phoenix-devc/8085--Microproccesor/README.md

# 8085-Microprocessor
Semester 6 Microprocessor Project
Youtube Video Link: https://youtu.be/vXMi8Nels3E
