phoenix-devc/8085--Microproccesor/Proposal Gantt Chart.docx

Task | Start Date(DD/MM/YY) | End Date(DD/MM/YY) | Duration
Project Proposal
Basics of 8085 & Assembly Language
Analysing Hardware Requirements
Schematic Development
Constructing the Board Layout
SD(1): Basic Tic-Tac-Toe Model
SD(2): Constructing Minmax Algorithm Model
Ordering and Obtaining the PCB
Fabricating the Board
Conducting Alpha Tests
