phoenix-devc/8085--Microproccesor/Model_1 (9).pdf

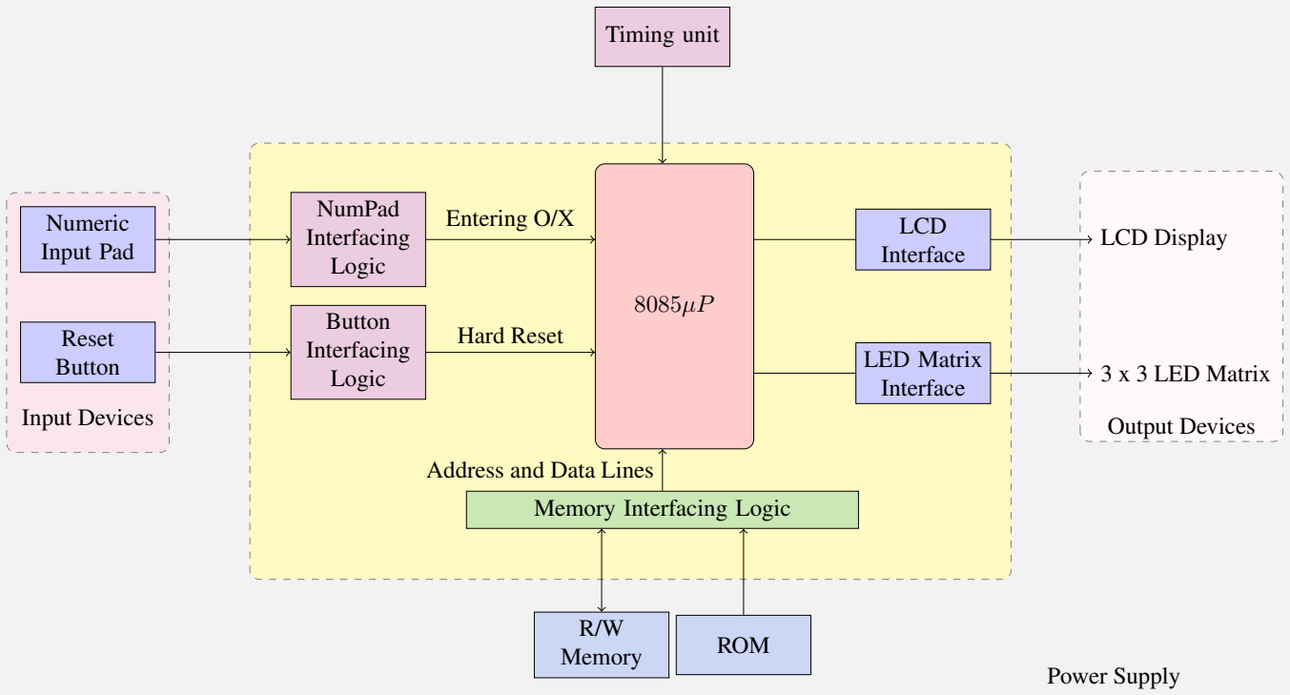
[picture p14: figure]
Numeric Input Pad; Power Supply; Reset Button; NumPad Interfacing Logic; Button Interfacing Logic; Memory Interfacing Logic; Memory; ROM; Timing unit; Entering O/X; Hard Reset; Address and Data Lines; Input Devices; Output Devices; LCD Interface; LCD Display; LED Matrix; Interface; 3 x 3 LED Matrix
