phoenix-devc/8085--Microproccesor/FINALGANTTCHARTSMART.png

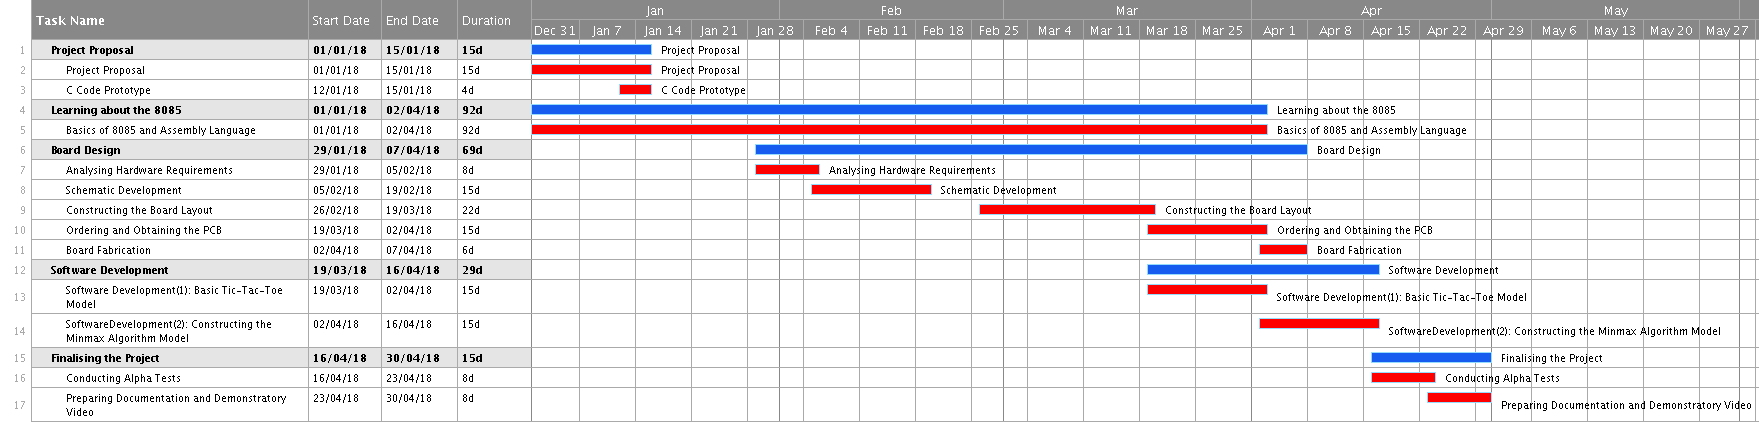
FINALGANTTCHARTSMART.png
