phoenix-devc/8085--Microproccesor/ganttusingsmartsheet.png

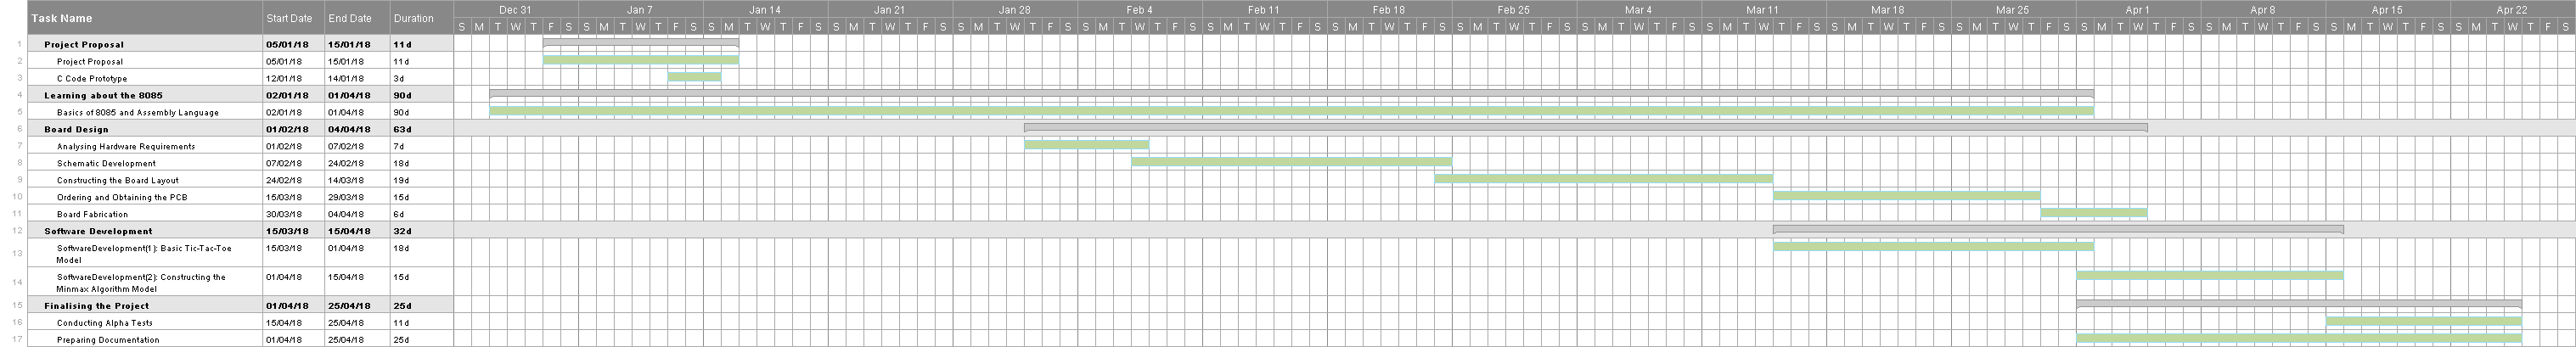
ganttusingsmartsheet.png
