phoenix-devc/8085--Microproccesor/Schematic/main_schematic_2.sch

## EAGLE design Schematic/main_schematic_2.sch (2018-03-11)

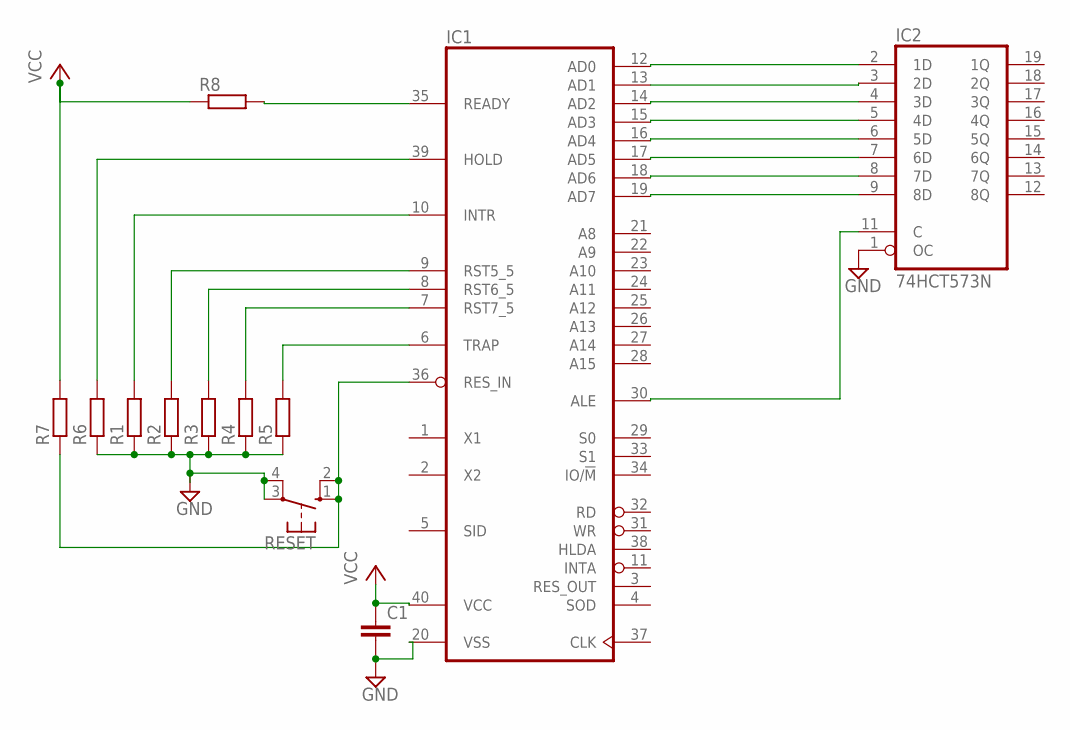
[picture p17: schematic main_schematic_2.sch]

Parts:
C1: C2,5-3; C2.5-3
IC1: 8085; DIL40
IC2: 74HCT573N; DIL20
R1, R2, R3, R4, R5, R6, R7, R8: R0204/7; 0204/7
RESET: 10-XX; B3F-10XX

Connections:
GND: C1.2, IC1.20 (VSS), R1.1, R2.1, R3.1, R4.1, R5.1, R6.1, RESET.3, RESET.4 (P1)
unnamed: IC1.39 (HOLD), R6.2
unnamed: IC1.10 (INTR), R1.2
unnamed: IC1.9 (RST5_5), R2.2
unnamed: IC1.8 (RST6_5), R3.2
unnamed: IC1.7 (RST7_5), R4.2
unnamed: IC1.6 (TRAP), R5.2
unnamed: IC1.36 (RES_IN), R7.1, RESET.1 (S), RESET.2 (S1)
unnamed: IC1.35 (READY), R8.2
unnamed: IC1.30 (ALE), IC2.11 (C)
unnamed: IC1.12 (AD0), IC2.2 (1D)
unnamed: IC1.13 (AD1), IC2.3 (2D)
unnamed: IC1.14 (AD2), IC2.4 (3D)
unnamed: IC1.15 (AD3), IC2.5 (4D)
unnamed: IC1.16 (AD4), IC2.6 (5D)
unnamed: IC1.17 (AD5), IC2.7 (6D)
unnamed: IC1.18 (AD6), IC2.8 (7D)
unnamed: IC1.19 (AD7), IC2.9 (8D)
VCC: C1.1, IC1.40 (VCC), R7.2, R8.1
