phoenix-devc/8085--Microproccesor/Schematic/main_schematic_3.sch

## EAGLE design Schematic/main_schematic_3.sch (2018-03-14)

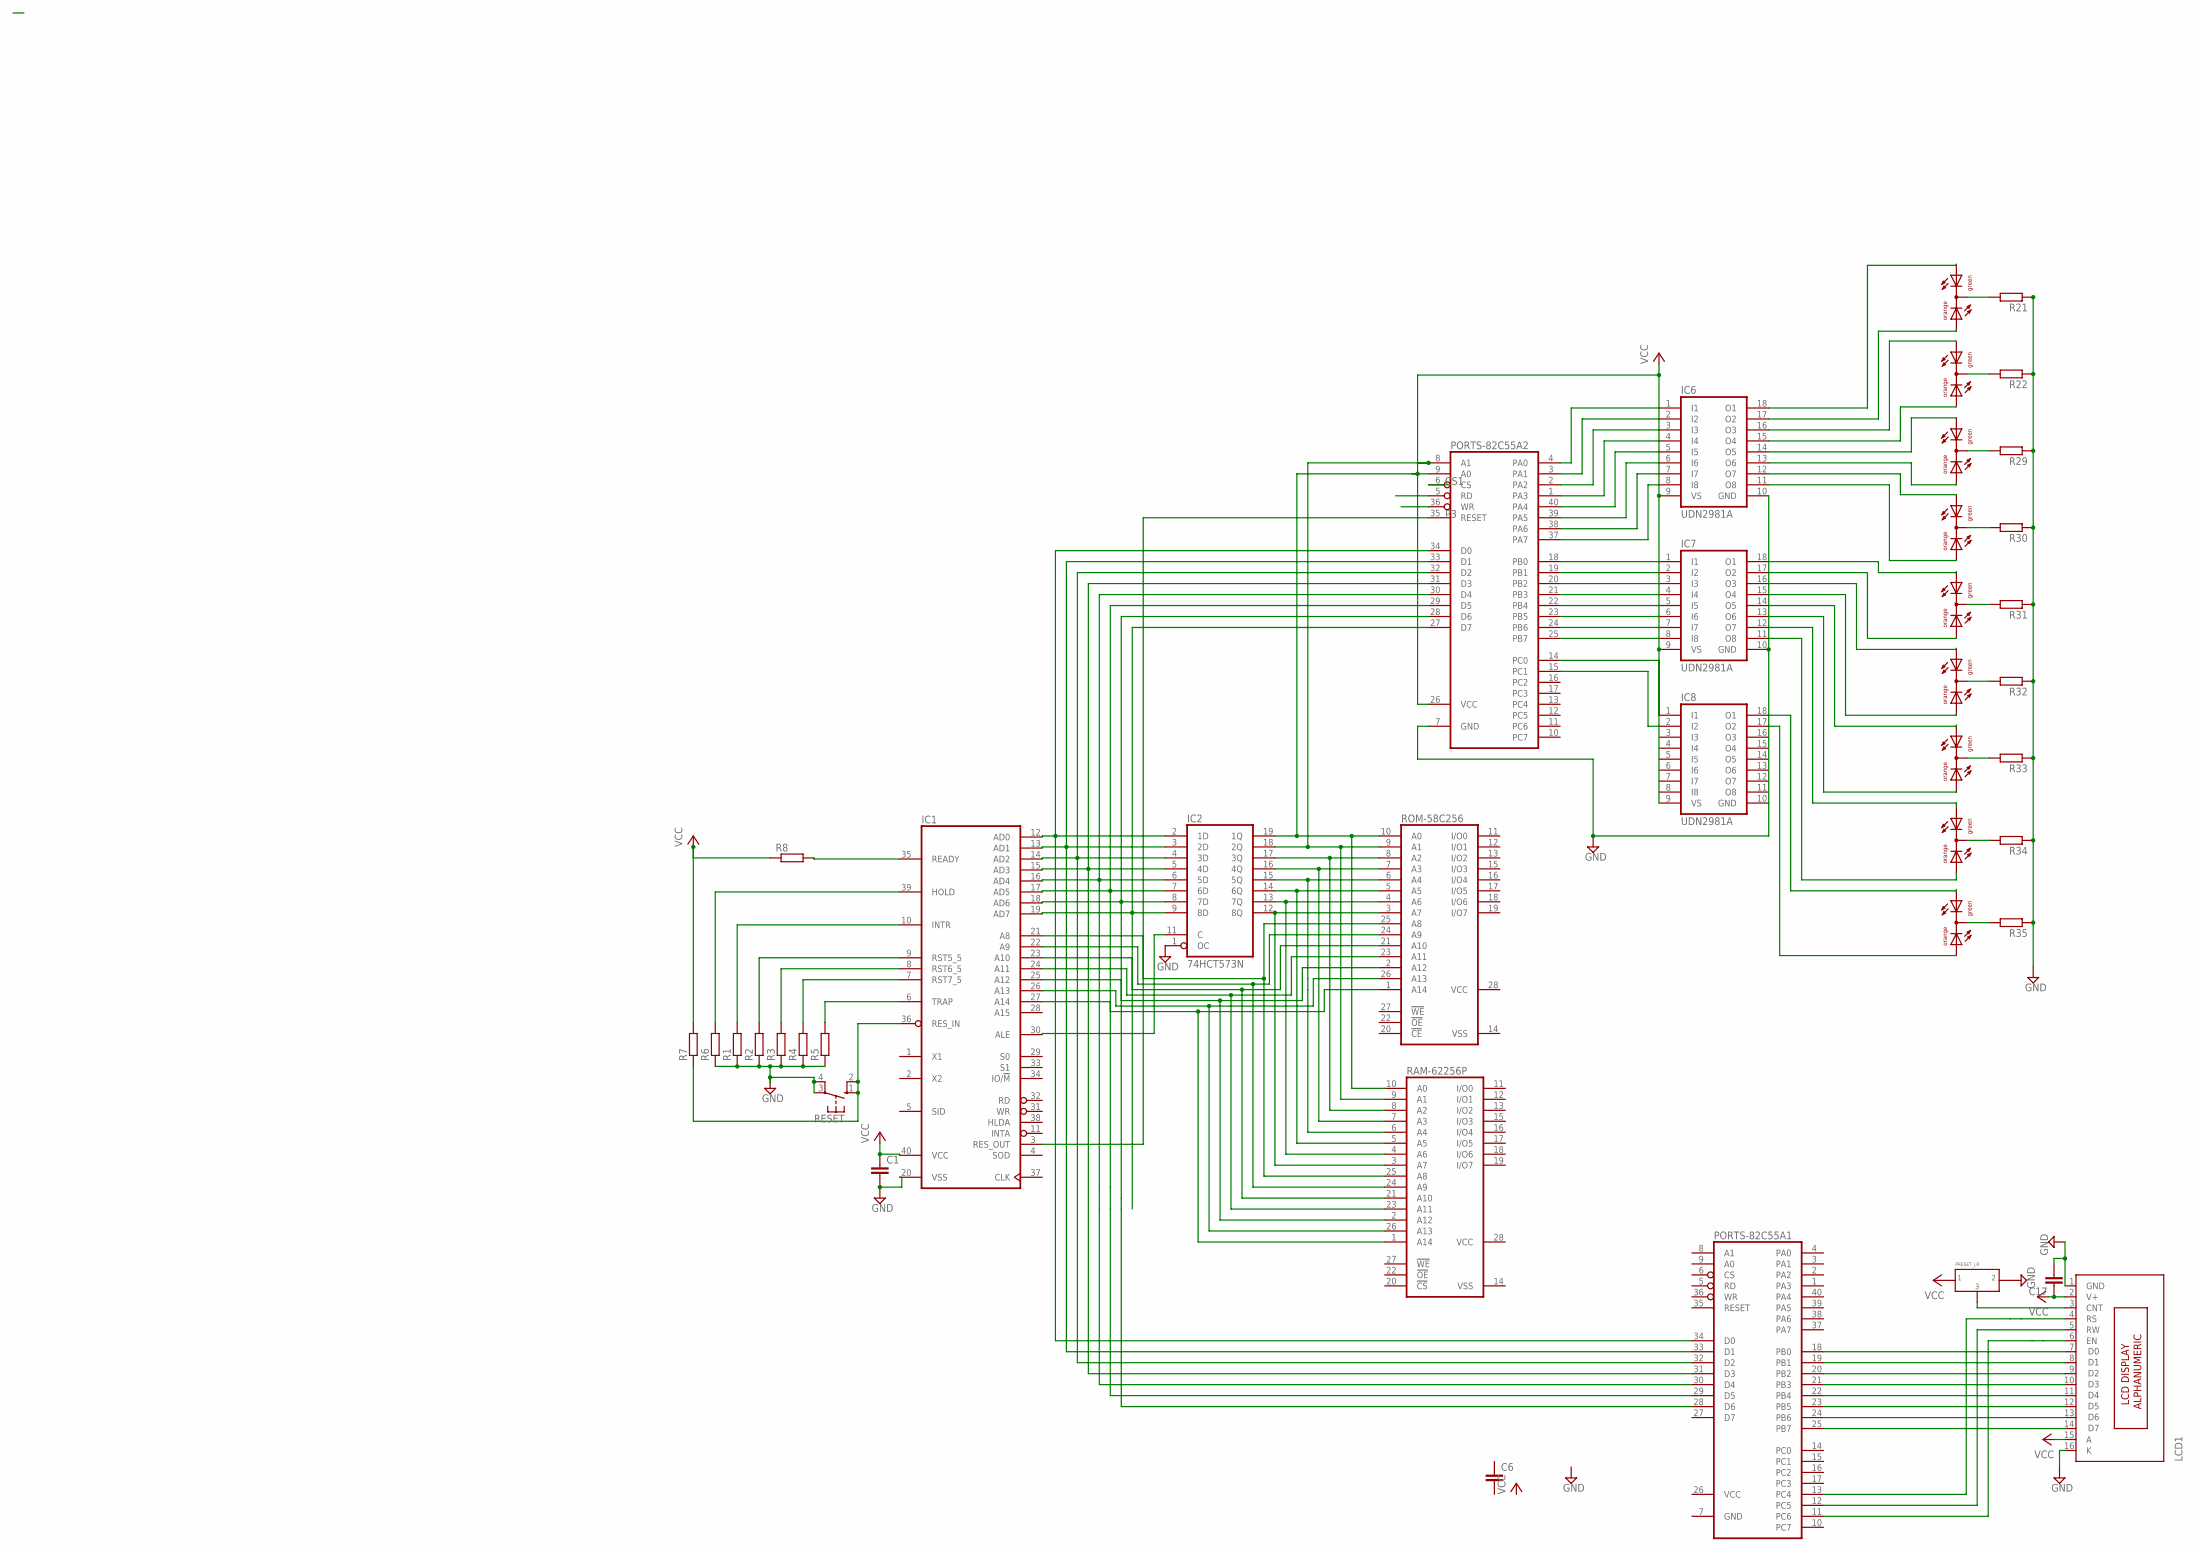
[picture p18: schematic main_schematic_3.sch]

Parts:
C1: C2,5-3; C2.5-3
C6: C-EU050-024X044; C050-024X044
C17: C-EU025-024X044; C025-024X044
IC1: 8085; DIL40
IC2: 74HCT573N; DIL20
IC6, IC7, IC8: UDN2981A; DIL18
LCD1: 16X2LCD; 16X2_LCD
LED1, LED11, LED12, LED13, LED14, LED15, LED16, LED17, LED18: TLUV5300
PORTS-82C55A1, PORTS-82C55A2: 82C55A; DIL40
R1, R2, R3, R4, R5, R6, R7, R8: R0204/7; 0204/7
R21, R22, R29, R30, R31, R32, R33, R34, R35: R-EU_0204/7; 0204/7
RAM-62256P: 62256P; DIL28-6
RESET: 10-XX; B3F-10XX
ROM-58C256: 58C256P; DIL28-6
U$2: PRESET_LR

Connections:
A0: PORTS-82C55A2.9 (A0)
A1: IC2.18 (2Q), PORTS-82C55A2.8 (A1), RAM-62256P.9 (A1), ROM-58C256.9 (A1)
CS1: PORTS-82C55A2.6 (CS)
GND: C1.2, C17.2, IC1.20 (VSS), IC6.10 (GND), IC7.10 (GND), IC8.10 (GND), LCD1.1 (GND), LCD1.16 (K), PORTS-82C55A2.7 (GND), R1.1, R2.1, R3.1, R4.1, R5.1, R6.1, R21.1, R22.1, R29.1, R30.1, R31.1, R32.1, R33.1, R34.1, R35.1, RESET.3, RESET.4 (P1), U$2.P$2 (2)
unnamed: IC1.39 (HOLD), R6.2
unnamed: IC1.10 (INTR), R1.2
unnamed: IC1.9 (RST5_5), R2.2
unnamed: IC1.8 (RST6_5), R3.2
unnamed: IC1.7 (RST7_5), R4.2
unnamed: IC1.6 (TRAP), R5.2
unnamed: IC1.36 (RES_IN), R7.1, RESET.1 (S), RESET.2 (S1)
unnamed: IC1.35 (READY), R8.2
unnamed: IC1.30 (ALE), IC2.11 (C)
unnamed: IC6.1 (I1), PORTS-82C55A2.4 (PA0)
unnamed: IC6.2 (I2), PORTS-82C55A2.3 (PA1)
unnamed: IC7.1 (I1), PORTS-82C55A2.18 (PB0)
unnamed: IC6.3 (I3), PORTS-82C55A2.2 (PA2)
unnamed: IC6.4 (I4), PORTS-82C55A2.1 (PA3)
unnamed: IC6.5 (I5), PORTS-82C55A2.40 (PA4)
unnamed: IC6.6 (I6), PORTS-82C55A2.39 (PA5)
unnamed: IC6.7 (I7), PORTS-82C55A2.38 (PA6)
unnamed: LCD1.4 (RS), PORTS-82C55A1.13 (PC4)
unnamed: LCD1.5 (RW), PORTS-82C55A1.12 (PC5)
unnamed: LCD1.6 (EN), PORTS-82C55A1.11 (PC6)
unnamed: LCD1.14 (D7), PORTS-82C55A1.25 (PB7)
unnamed: LCD1.13 (D6), PORTS-82C55A1.24 (PB6)
unnamed: LCD1.12 (D5), PORTS-82C55A1.23 (PB5)
unnamed: IC2.17 (3Q), RAM-62256P.8 (A2), ROM-58C256.8 (A2)
unnamed: IC2.16 (4Q), RAM-62256P.7 (A3), ROM-58C256.7 (A3)
unnamed: LCD1.11 (D4), PORTS-82C55A1.22 (PB4)
unnamed: LCD1.10 (D3), PORTS-82C55A1.21 (PB3)
unnamed: LCD1.9 (D2), PORTS-82C55A1.20 (PB2)
unnamed: LCD1.8 (D1), PORTS-82C55A1.19 (PB1)
unnamed: LCD1.7 (D0), PORTS-82C55A1.18 (PB0)
unnamed: LCD1.3 (CNT), U$2.P$3 (3)
unnamed: IC2.15 (5Q), RAM-62256P.6 (A4), ROM-58C256.6 (A4)
unnamed: IC2.14 (6Q), RAM-62256P.5 (A5), ROM-58C256.5 (A5)
unnamed: IC2.13 (7Q), RAM-62256P.4 (A6), ROM-58C256.4 (A6)
unnamed: IC2.12 (8Q), RAM-62256P.3 (A7), ROM-58C256.3 (A7)
unnamed: IC1.21 (A8), RAM-62256P.25 (A8), ROM-58C256.25 (A8)
unnamed: IC1.22 (A9), RAM-62256P.24 (A9), ROM-58C256.24 (A9)
unnamed: IC1.23 (A10), RAM-62256P.21 (A10), ROM-58C256.21 (A10)
unnamed: IC1.24 (A11), RAM-62256P.23 (A11), ROM-58C256.23 (A11)
unnamed: IC1.25 (A12), RAM-62256P.2 (A12), ROM-58C256.2 (A12)
unnamed: IC1.26 (A13), RAM-62256P.26 (A13), ROM-58C256.26 (A13)
unnamed: IC1.27 (A14), RAM-62256P.1 (A14), ROM-58C256.1 (A14)
unnamed: IC6.8 (I8), PORTS-82C55A2.37 (PA7)
unnamed: IC7.2 (I2), PORTS-82C55A2.19 (PB1)
unnamed: IC7.3 (I3), PORTS-82C55A2.20 (PB2)
unnamed: IC7.4 (I4), PORTS-82C55A2.21 (PB3)
unnamed: IC7.5 (I5), PORTS-82C55A2.22 (PB4)
unnamed: IC7.6 (I6), PORTS-82C55A2.23 (PB5)
unnamed: IC7.7 (I7), PORTS-82C55A2.24 (PB6)
unnamed: IC7.8 (I8), PORTS-82C55A2.25 (PB7)
unnamed: IC8.1 (I1), PORTS-82C55A2.14 (PC0)
unnamed: IC8.2 (I2), PORTS-82C55A2.15 (PC1)
unnamed: IC6.18 (O1), LED1.AG
unnamed: IC6.17 (O2), LED1.AO
unnamed: IC6.16 (O3), LED11.AG
unnamed: IC6.15 (O4), LED11.AO
unnamed: IC6.14 (O5), LED12.AG
unnamed: IC6.13 (O6), LED12.AO
unnamed: IC6.12 (O7), LED13.AG
unnamed: IC6.11 (O8), LED13.AO
unnamed: IC7.18 (O1), LED14.AG
unnamed: IC7.17 (O2), LED14.AO
unnamed: IC7.16 (O3), LED15.AG
unnamed: IC7.15 (O4), LED15.AO
unnamed: IC7.14 (O5), LED16.AG
unnamed: IC7.13 (O6), LED16.AO
unnamed: IC7.12 (O7), LED17.AG
unnamed: IC7.11 (O8), LED17.AO
unnamed: IC8.18 (O1), LED18.AG
unnamed: IC8.17 (O2), LED18.AO
unnamed: LED18.CC, R35.2
unnamed: LED17.CC, R34.2
unnamed: LED16.CC, R33.2
unnamed: LED15.CC, R32.2
unnamed: LED13.CC, R30.2
unnamed: LED12.CC, R29.2
unnamed: LED11.CC, R22.2
unnamed: LED1.CC, R21.2
unnamed: LED14.CC, R31.2
NETSEG1: PORTS-82C55A2.5 (RD)
P1: IC1.12 (AD0), IC2.2 (1D), PORTS-82C55A1.34 (D0), PORTS-82C55A2.34 (D0)
P2: IC1.13 (AD1), IC2.3 (2D), PORTS-82C55A1.33 (D1), PORTS-82C55A2.33 (D1)
P3: IC1.3 (RES_OUT), PORTS-82C55A2.35 (RESET)
P4: IC1.14 (AD2), IC2.4 (3D), PORTS-82C55A1.32 (D2), PORTS-82C55A2.32 (D2)
P5: IC1.15 (AD3), IC2.5 (4D), PORTS-82C55A1.31 (D3), PORTS-82C55A2.31 (D3)
P6: IC1.17 (AD5), IC2.7 (6D), PORTS-82C55A1.29 (D5), PORTS-82C55A2.29 (D5)
P7: IC1.19 (AD7), IC2.9 (8D), PORTS-82C55A2.27 (D7)
P8: IC1.18 (AD6), IC2.8 (7D), PORTS-82C55A1.28 (D6), PORTS-82C55A2.28 (D6)
P9: IC1.16 (AD4), IC2.6 (5D), PORTS-82C55A1.30 (D4), PORTS-82C55A2.30 (D4)
VCC: C1.1, C17.1, IC1.40 (VCC), IC2.19 (1Q), IC6.9 (VS), IC7.9 (VS), IC8.9 (VS), LCD1.2 (V+), LCD1.15 (A), PORTS-82C55A2.26 (VCC), R7.2, R8.1, RAM-62256P.10 (A0), ROM-58C256.10 (A0), U$2.P$1 (1)
