phoenix-devc/8085--Microproccesor/Schematic/main_schematic_8.sch

## EAGLE design Schematic/main_schematic_8.sch (2018-03-17)

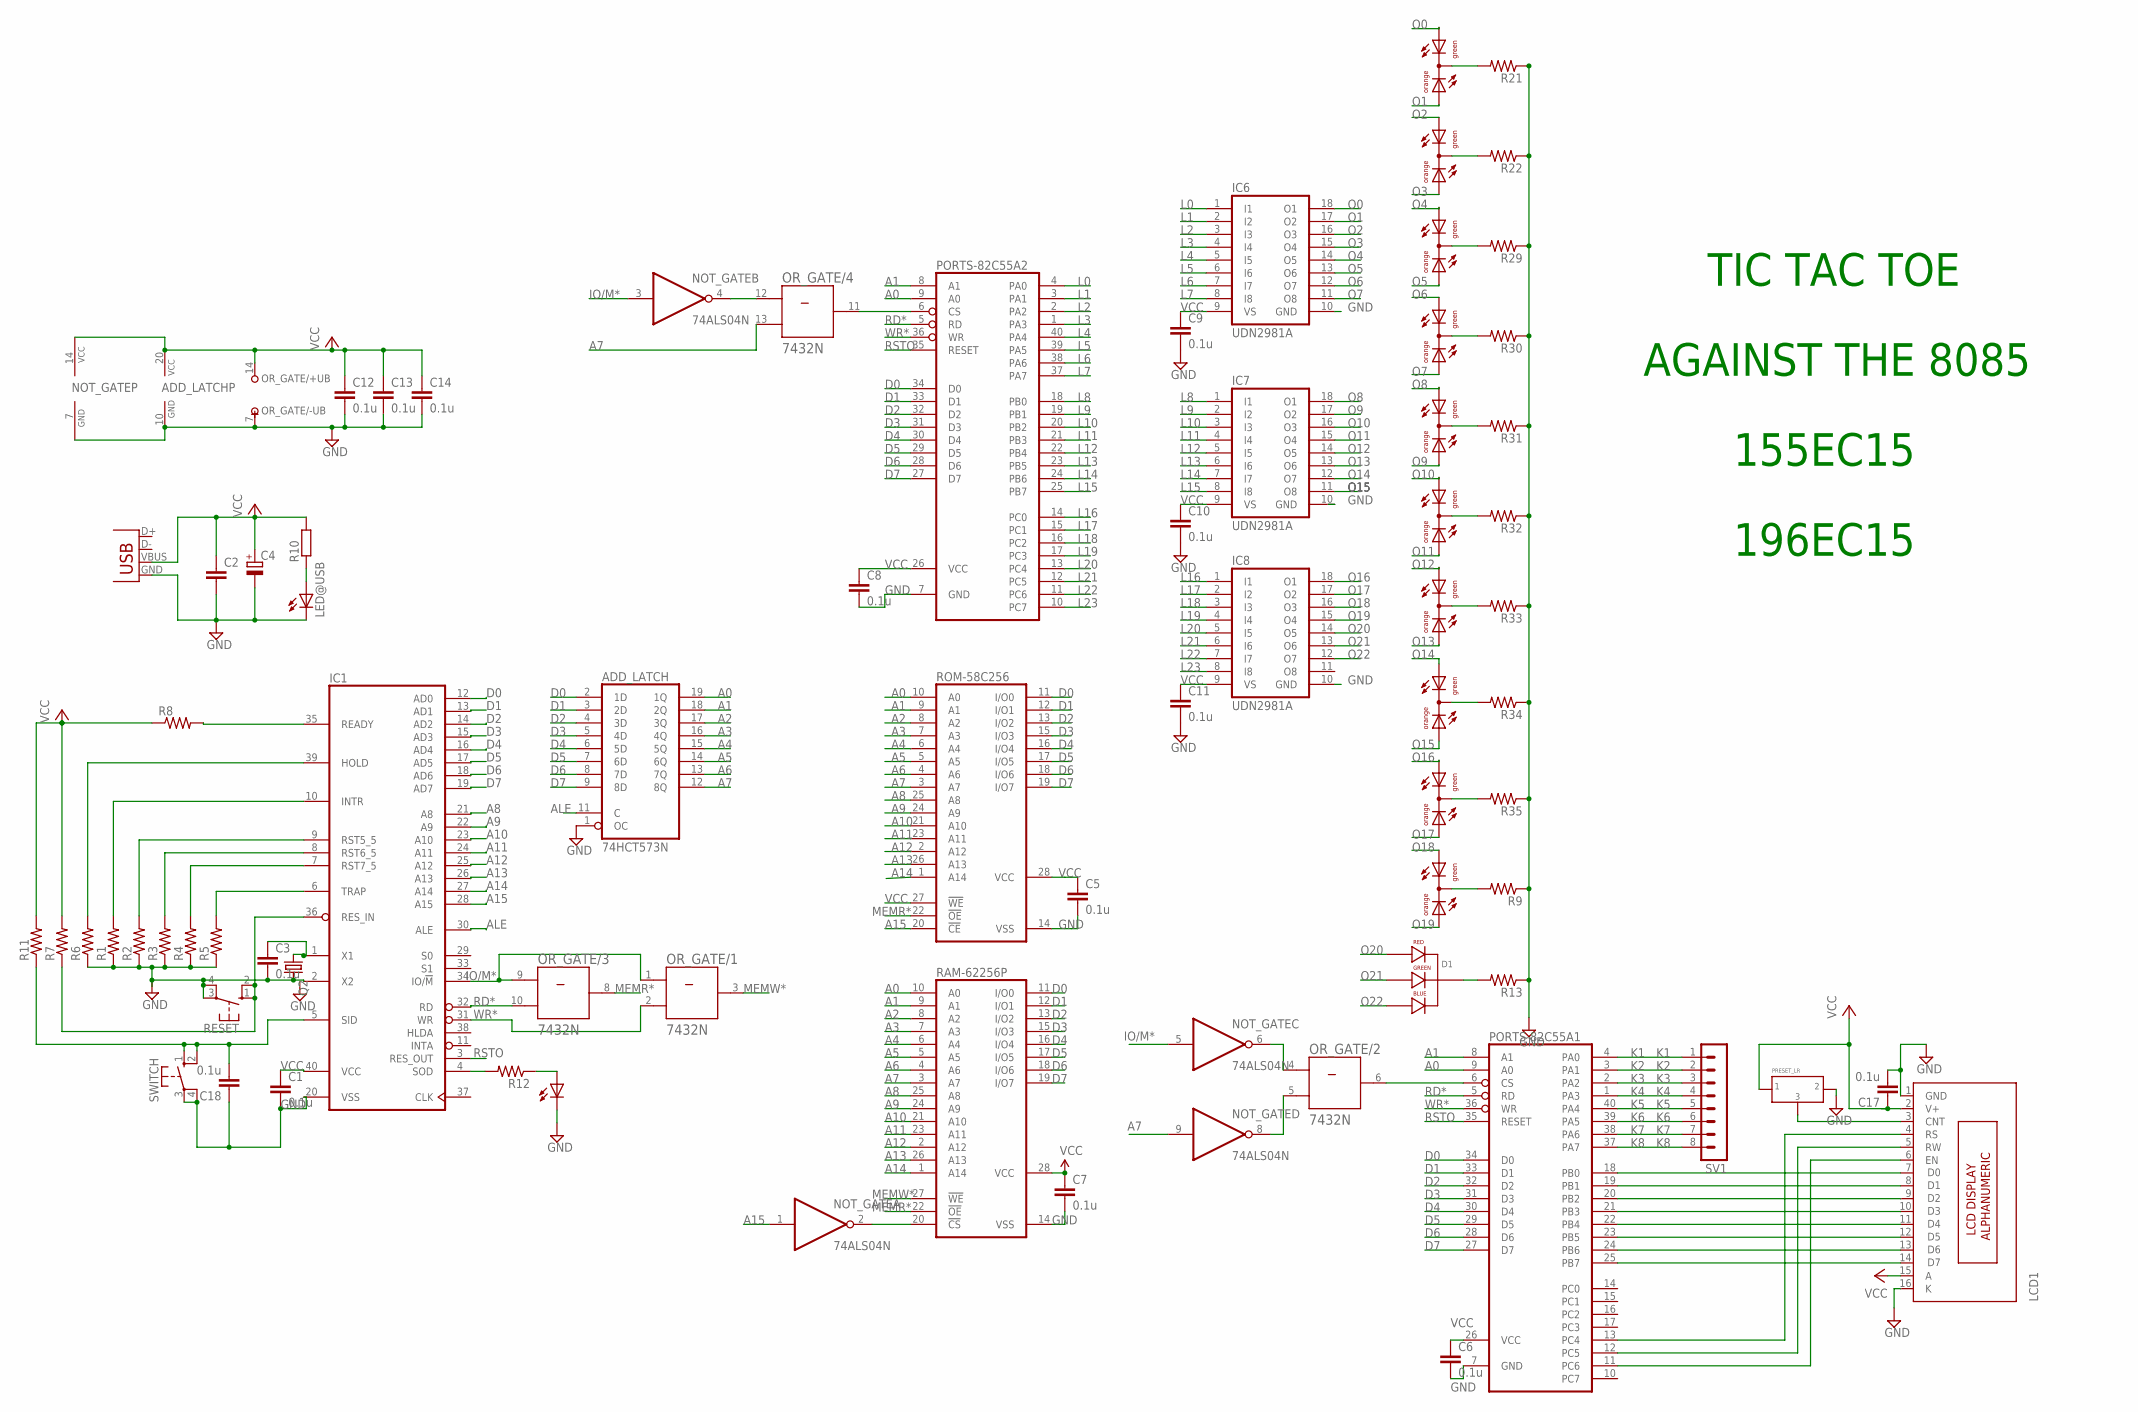
[picture p21: schematic main_schematic_8.sch]

Parts:
ADD_LATCH: 74HCT573N; DIL20
C1, C18: 0.1u; C2.5-3
C2: C-EU025-024X044; C025-024X044
C3, C5, C7, C8, C9, C10, C11, C12, C13, C14, C17: 0.1u; C025-024X044
C4: CPOL-EUE5-8.5; E5-8,5
C6: 0.1u; C050-024X044
D1: LED-RGB-CC-THRUCLEAR; LED-RGB-THRU
IC1: 8085; DIL40
IC6, IC7, IC8: UDN2981A; DIL18
LCD1: 16X2LCD; 16X2_LCD
LED@SOD: LED3MM
LED@USB: LED5MM
LEDA: TLUV5300
LEDB: TLUV5300
LEDC: TLUV5300
LEDD: TLUV5300
LEDE: TLUV5300
LEDF: TLUV5300
LEDG: TLUV5300
LEDH: TLUV5300
LEDI: TLUV5300
LEDJ: TLUV5300
NOT_GATE: 74ALS04N; DIL14
OR_GATE: 7432N; DIL14
PORTS-82C55A1, PORTS-82C55A2: 82C55A; DIL40
Q2: CRYSTALHC49US; HC49US
R1, R2, R3, R4, R5, R6, R7, R8, R9, R11, R12, R13, R21, R22, R29, R30, R31, R32, R33, R34, R35: R-US_0204/2V; 0204V
R10: R-EU_0204/7; 0204/7
RAM-62256P: 62256P; DIL28-6
RESET: 10-XX; B3F-10XX
ROM-58C256: 58C256P; DIL28-6
SV1: MA08-1
SWITCH: 10-XX; B3F-10XX
U$2: PRESET_LR
X1: USBSMD; USB-MINIB

Connections:
A0: ADD_LATCH.19 (1Q), PORTS-82C55A1.9 (A0), PORTS-82C55A2.9 (A0), RAM-62256P.10 (A0), ROM-58C256.10 (A0)
A1: ADD_LATCH.18 (2Q), PORTS-82C55A1.8 (A1), PORTS-82C55A2.8 (A1), RAM-62256P.9 (A1), ROM-58C256.9 (A1)
A2: ADD_LATCH.17 (3Q), RAM-62256P.8 (A2), ROM-58C256.8 (A2)
A3: ADD_LATCH.16 (4Q), RAM-62256P.7 (A3), ROM-58C256.7 (A3)
A4: ADD_LATCH.15 (5Q), RAM-62256P.6 (A4), ROM-58C256.6 (A4)
A5: ADD_LATCH.14 (6Q), RAM-62256P.5 (A5), ROM-58C256.5 (A5)
A6: ADD_LATCH.13 (7Q), RAM-62256P.4 (A6), ROM-58C256.4 (A6)
A7: ADD_LATCH.12 (8Q), NOT_GATE.9 (I), OR_GATE.13 (B), RAM-62256P.3 (A7), ROM-58C256.3 (A7)
A8: IC1.21 (A8), RAM-62256P.25 (A8), ROM-58C256.25 (A8)
A9: IC1.22 (A9), RAM-62256P.24 (A9), ROM-58C256.24 (A9)
A10: IC1.23 (A10), RAM-62256P.21 (A10), ROM-58C256.21 (A10)
A11: IC1.24 (A11), RAM-62256P.23 (A11), ROM-58C256.23 (A11)
A12: IC1.25 (A12), RAM-62256P.2 (A12), ROM-58C256.2 (A12)
A13: IC1.26 (A13), RAM-62256P.26 (A13), ROM-58C256.26 (A13)
A14: IC1.27 (A14), RAM-62256P.1 (A14), ROM-58C256.1 (A14)
A15: IC1.28 (A15), NOT_GATE.1 (I), ROM-58C256.20 (!CE)
ALE: ADD_LATCH.11 (C), IC1.30 (ALE)
D0: ADD_LATCH.2 (1D), IC1.12 (AD0), PORTS-82C55A1.34 (D0), PORTS-82C55A2.34 (D0), RAM-62256P.11 (I/O0), ROM-58C256.11 (I/O0)
D1: ADD_LATCH.3 (2D), IC1.13 (AD1), PORTS-82C55A1.33 (D1), PORTS-82C55A2.33 (D1), RAM-62256P.12 (I/O1), ROM-58C256.12 (I/O1)
D2: ADD_LATCH.4 (3D), IC1.14 (AD2), PORTS-82C55A1.32 (D2), PORTS-82C55A2.32 (D2), RAM-62256P.13 (I/O2), ROM-58C256.13 (I/O2)
D3: ADD_LATCH.5 (4D), IC1.15 (AD3), PORTS-82C55A1.31 (D3), PORTS-82C55A2.31 (D3), RAM-62256P.15 (I/O3), ROM-58C256.15 (I/O3)
D4: ADD_LATCH.6 (5D), IC1.16 (AD4), PORTS-82C55A1.30 (D4), PORTS-82C55A2.30 (D4), RAM-62256P.16 (I/O4), ROM-58C256.16 (I/O4)
D5: ADD_LATCH.7 (6D), IC1.17 (AD5), PORTS-82C55A1.29 (D5), PORTS-82C55A2.29 (D5), RAM-62256P.17 (I/O5), ROM-58C256.17 (I/O5)
D6: ADD_LATCH.8 (7D), IC1.18 (AD6), PORTS-82C55A1.28 (D6), PORTS-82C55A2.28 (D6), RAM-62256P.18 (I/O6), ROM-58C256.18 (I/O6)
D7: ADD_LATCH.9 (8D), IC1.19 (AD7), PORTS-82C55A1.27 (D7), PORTS-82C55A2.27 (D7), RAM-62256P.19 (I/O7), ROM-58C256.19 (I/O7)
GND: ADD_LATCH.1 (OC), ADD_LATCH.10 (GND), C1.2, C2.2, C3.2, C4.-, C5.2, C6.2, C7.2, C8.2, C9.2, C10.2, C11.2, C12.2, C13.2, C14.2, C17.2, C18.1, IC1.2 (X2), IC1.20 (VSS), IC6.10 (GND), IC7.10 (GND), IC8.10 (GND), LCD1.1 (GND), LCD1.16 (K), LED@SOD.K (C), LED@USB.K (C), NOT_GATE.7 (GND), OR_GATE.7 (-UB), PORTS-82C55A1.7 (GND), PORTS-82C55A2.7 (GND), Q2.2, R1.1, R2.1, R3.1, R4.1, R5.1, R6.1, R9.1, R13.1, R21.1, R22.1, R29.1, R30.1, R31.1, R32.1, R33.1, R34.1, R35.1, RAM-62256P.14 (VSS), RESET.3, RESET.4 (P1), ROM-58C256.14 (VSS), SWITCH.3, SWITCH.4 (P1), U$2.P$2 (2), X1.GND
IO/M*: IC1.34 (IO/!M), NOT_GATE.3 (I), NOT_GATE.5 (I), OR_GATE.1 (A), OR_GATE.9 (A)
K1: PORTS-82C55A1.4 (PA0), SV1.1
K2: PORTS-82C55A1.3 (PA1), SV1.2
K3: PORTS-82C55A1.2 (PA2), SV1.3
K4: PORTS-82C55A1.1 (PA3), SV1.4
K5: PORTS-82C55A1.40 (PA4), SV1.5
K6: PORTS-82C55A1.39 (PA5), SV1.6
K7: PORTS-82C55A1.38 (PA6), SV1.7
K8: PORTS-82C55A1.37 (PA7), SV1.8
L0: IC6.1 (I1), PORTS-82C55A2.4 (PA0)
L1: IC6.2 (I2), PORTS-82C55A2.3 (PA1)
L2: IC6.3 (I3), PORTS-82C55A2.2 (PA2)
L3: IC6.4 (I4), PORTS-82C55A2.1 (PA3)
L4: IC6.5 (I5), PORTS-82C55A2.40 (PA4)
L5: IC6.6 (I6), PORTS-82C55A2.39 (PA5)
L6: IC6.7 (I7), PORTS-82C55A2.38 (PA6)
L7: IC6.8 (I8), PORTS-82C55A2.37 (PA7)
L8: IC7.1 (I1), PORTS-82C55A2.18 (PB0)
L9: IC7.2 (I2), PORTS-82C55A2.19 (PB1)
L10: IC7.3 (I3), PORTS-82C55A2.20 (PB2)
L11: IC7.4 (I4), PORTS-82C55A2.21 (PB3)
L12: IC7.5 (I5), PORTS-82C55A2.22 (PB4)
L13: IC7.6 (I6), PORTS-82C55A2.23 (PB5)
L14: IC7.7 (I7), PORTS-82C55A2.24 (PB6)
L15: IC7.8 (I8), PORTS-82C55A2.25 (PB7)
L16: IC8.1 (I1), PORTS-82C55A2.14 (PC0)
L17: IC8.2 (I2), PORTS-82C55A2.15 (PC1)
L18: IC8.3 (I3), PORTS-82C55A2.16 (PC2)
L19: IC8.4 (I4), PORTS-82C55A2.17 (PC3)
L20: IC8.5 (I5), PORTS-82C55A2.13 (PC4)
L21: IC8.6 (I6), PORTS-82C55A2.12 (PC5)
L22: IC8.7 (I7), PORTS-82C55A2.11 (PC6)
L23: IC8.8 (I8), PORTS-82C55A2.10 (PC7)
MEMR*: OR_GATE.8 (Y), RAM-62256P.22 (!OE), ROM-58C256.22 (!OE)
MEMW*: OR_GATE.3 (Y), RAM-62256P.27 (!WE)
unnamed: IC1.39 (HOLD), R6.2
unnamed: IC1.10 (INTR), R1.2
unnamed: IC1.9 (RST5_5), R2.2
unnamed: IC1.8 (RST6_5), R3.2
unnamed: IC1.7 (RST7_5), R4.2
unnamed: IC1.6 (TRAP), R5.2
unnamed: IC1.36 (RES_IN), R7.1, RESET.1 (S), RESET.2 (S1)
unnamed: IC1.35 (READY), R8.2
unnamed: C18.2, IC1.5 (SID), R11.1, SWITCH.1 (S), SWITCH.2 (S1)
unnamed: C3.1, IC1.1 (X1), Q2.1
unnamed: NOT_GATE.2 (O), RAM-62256P.20 (!CS)
unnamed: D1.2 (CATHODE), R13.2
unnamed: NOT_GATE.6 (O), OR_GATE.4 (A)
unnamed: IC1.4 (SOD), R12.2
unnamed: LED@SOD.A, R12.1
unnamed: OR_GATE.6 (Y), PORTS-82C55A1.6 (CS)
unnamed: OR_GATE.11 (Y), PORTS-82C55A2.6 (CS)
unnamed: LCD1.4 (RS), PORTS-82C55A1.13 (PC4)
unnamed: LCD1.5 (RW), PORTS-82C55A1.12 (PC5)
unnamed: LCD1.6 (EN), PORTS-82C55A1.11 (PC6)
unnamed: LEDJ.CC, R9.2
unnamed: NOT_GATE.4 (O), OR_GATE.12 (A)
unnamed: NOT_GATE.8 (O), OR_GATE.5 (B)
unnamed: LED@USB.A, R10.1
unnamed: LCD1.14 (D7), PORTS-82C55A1.25 (PB7)
unnamed: LCD1.13 (D6), PORTS-82C55A1.24 (PB6)
unnamed: LCD1.12 (D5), PORTS-82C55A1.23 (PB5)
unnamed: LCD1.11 (D4), PORTS-82C55A1.22 (PB4)
unnamed: LCD1.10 (D3), PORTS-82C55A1.21 (PB3)
unnamed: LCD1.9 (D2), PORTS-82C55A1.20 (PB2)
unnamed: LCD1.8 (D1), PORTS-82C55A1.19 (PB1)
unnamed: LCD1.7 (D0), PORTS-82C55A1.18 (PB0)
unnamed: LCD1.3 (CNT), U$2.P$3 (3)
unnamed: LEDI.CC, R35.2
unnamed: LEDH.CC, R34.2
unnamed: LEDG.CC, R33.2
unnamed: LEDF.CC, R32.2
unnamed: LEDD.CC, R30.2
unnamed: LEDC.CC, R29.2
unnamed: LEDB.CC, R22.2
unnamed: LEDA.CC, R21.2
unnamed: LEDE.CC, R31.2
O0: IC6.18 (O1), LEDA.AG
O1: IC6.17 (O2), LEDA.AO
O2: IC6.16 (O3), LEDB.AG
O3: IC6.15 (O4), LEDB.AO
O4: IC6.14 (O5), LEDC.AG
O5: IC6.13 (O6), LEDC.AO
O6: IC6.12 (O7), LEDD.AG
O7: IC6.11 (O8), LEDD.AO
O8: IC7.18 (O1), LEDE.AG
O9: IC7.17 (O2), LEDE.AO
O10: IC7.16 (O3), LEDF.AG
O11: IC7.15 (O4), LEDF.AO
O12: IC7.14 (O5), LEDG.AG
O13: IC7.13 (O6), LEDG.AO
O14: IC7.12 (O7), LEDH.AG
O15: IC7.11 (O8), LEDH.AO
O16: IC8.18 (O1), LEDI.AG
O17: IC8.17 (O2), LEDI.AO
O18: IC8.16 (O3), LEDJ.AG
O19: IC8.15 (O4), LEDJ.AO
O20: D1.1 (RED_CATHODE), IC8.14 (O5)
O21: D1.3 (GREEN_CATHODE), IC8.13 (O6)
O22: D1.4 (BLUE_CATHODE), IC8.12 (O7)
RD*: IC1.32 (RD), OR_GATE.10 (B), PORTS-82C55A1.5 (RD), PORTS-82C55A2.5 (RD)
RSTO: IC1.3 (RES_OUT), PORTS-82C55A1.35 (RESET), PORTS-82C55A2.35 (RESET)
VCC: ADD_LATCH.20 (VCC), C1.1, C2.1, C4.+, C5.1, C6.1, C7.1, C8.1, C9.1, C10.1, C11.1, C12.1, C13.1, C14.1, C17.1, IC1.40 (VCC), IC6.9 (VS), IC7.9 (VS), IC8.9 (VS), LCD1.2 (V+), LCD1.15 (A), NOT_GATE.14 (VCC), OR_GATE.14 (+UB), PORTS-82C55A1.26 (VCC), PORTS-82C55A2.26 (VCC), R7.2, R8.1, R10.2, R11.2, RAM-62256P.28 (VCC), ROM-58C256.27 (!WE), ROM-58C256.28 (VCC), U$2.P$1 (1), X1.VBUS
WR*: IC1.31 (WR), OR_GATE.2 (B), PORTS-82C55A1.36 (WR), PORTS-82C55A2.36 (WR)

Notes on the sheet:
TIC TAC TOE
AGAINST THE 8085
155EC15
196EC15
