phoenix-devc/8085--Microproccesor/(commit log)

2018-01-27 Gantt Chart Excel Sheet
    [8085Gant.xlsx]
2018-01-28 Chart Inside
    [GanttChartwithChart.xlsx]
2018-01-28 Proposal
    A sample improvement
2018-01-31 Final Gantt Chart
    [FINALEXCELGANTTCHART.xlsx]
2018-03-10 Add files via upload
    Checkwin function implementation to evaluate the board state
2018-03-11 Board State Evaluator
2018-03-12 Using Checkwin for implementing TTT
    IGNORE I/O CODE
    ->VIEW BOARD USING PORTS EDITOR (displayed on ports 00-01-02/10-11-12/20-21-22)
    :D
2018-03-14 Progress till now
    [main_schematic_5.sch]
2018-03-17 Add files via upload
    Improved upon the schematic. Eliminated some Errors using ERC Check.
    [main_schematic_8.sch]
2018-05-20 Check Dates
    [FinalDates.xlsx]
2018-05-20 current version of latex documentation
2018-05-20 Current version of Latex Code
2018-05-20 BOM Files
    [tic_tac_toe_against_the_8085.csv]
